gurumodem/design/GuruModem.kicad_pcb

## KiCad design GuruModem.kicad_pcb (2019-03-13)

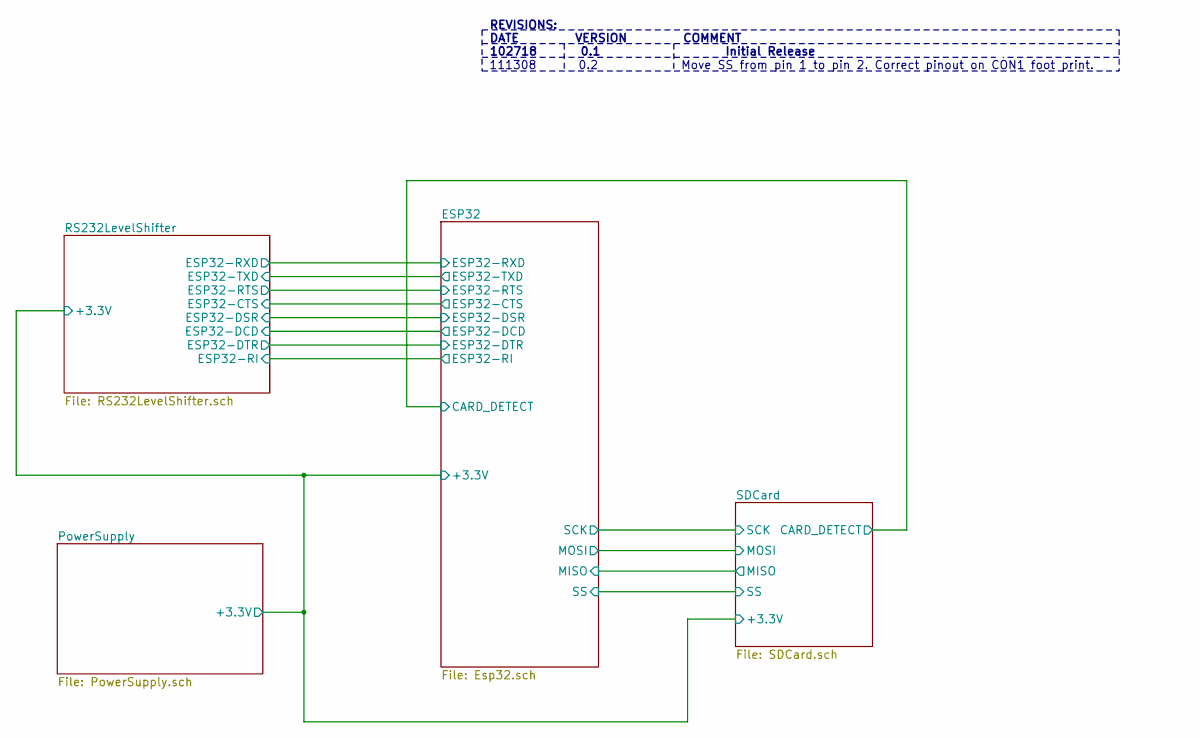
[picture p1: schematic GuruModem.sch, Guru Modem]

Notes on the sheet:
REVISIONS: DATE VERSION COMMENT 102718 0.1 Initial Release
111308
0.2
Move SS from pin 1 to pin 2. Correct pinout on CON1 foot print.

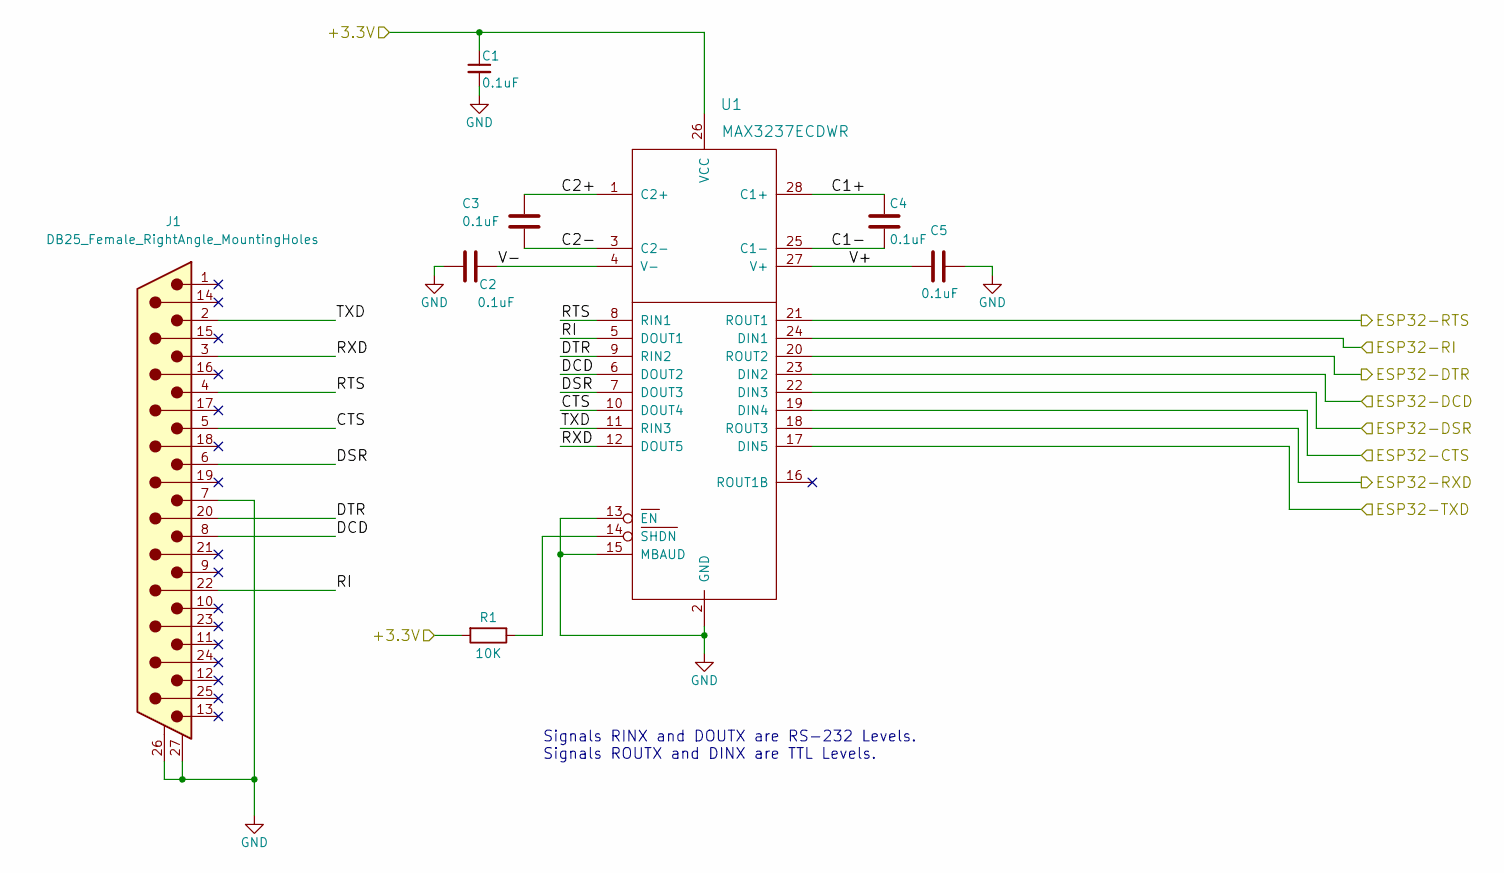
[picture p2: schematic RS232LevelShifter.sch, Guru Modem]

Parts:
C1, C2, C3, C4, C5: 0.1uF; C_0805
J1: DB25_Female_RightAngle_MountingHoles; DSUB-25_Female_RightAngle_MountingHoles
R1: 10K; R_0805
U1: MAX3237ECDWR; SOIC-28DW

Connections:
+3V3: C1.1, R1.2, U1.26 (VCC); also elsewhere on the board
/ESP32/ESP32-CTS: U1.19 (DIN4); also elsewhere on the board
/ESP32/ESP32-DCD: U1.23 (DIN2); also elsewhere on the board
/ESP32/ESP32-DSR: U1.22 (DIN3); also elsewhere on the board
/ESP32/ESP32-DTR: U1.20 (ROUT2); also elsewhere on the board
/ESP32/ESP32-RI: U1.24 (DIN1); also elsewhere on the board
/ESP32/ESP32-RTS: U1.21 (ROUT1); also elsewhere on the board
/ESP32/ESP32-RXD: U1.18 (ROUT3); also elsewhere on the board
/ESP32/ESP32-TXD: U1.17 (DIN5); also elsewhere on the board
/RS232LevelShifter/C1+: C4.1, U1.28 (C1+)
/RS232LevelShifter/C1-: C4.2, U1.25 (C1-)
/RS232LevelShifter/C2+: C3.1, U1.1 (C2+)
/RS232LevelShifter/C2-: C3.2, U1.3 (C2-)
/RS232LevelShifter/CTS: J1.5, U1.10 (DOUT4)
/RS232LevelShifter/DCD: J1.8, U1.6 (DOUT2)
/RS232LevelShifter/DSR: J1.6, U1.7 (DOUT3)
/RS232LevelShifter/DTR: J1.20, U1.9 (RIN2)
/RS232LevelShifter/RI: J1.22, U1.5 (DOUT1)
/RS232LevelShifter/RTS: J1.4, U1.8 (RIN1)
/RS232LevelShifter/RXD: J1.3, U1.12 (DOUT5)
/RS232LevelShifter/TXD: J1.2, U1.11 (RIN3)
/RS232LevelShifter/V+: C5.2, U1.27 (V+)
/RS232LevelShifter/V-: C2.2, U1.4 (V-)
GND: C1.2, C2.1, C5.1, J1.7, J1.26 (GND), J1.27 (GND), U1.2 (GND), U1.13 (EN), U1.15 (MBAUD); also elsewhere on the board
unnamed: R1.1, U1.14 (SHDN)

Notes on the sheet:
Signals RINX and DOUTX are RS-232 Levels. Signals ROUTX and DINX are TTL Levels.

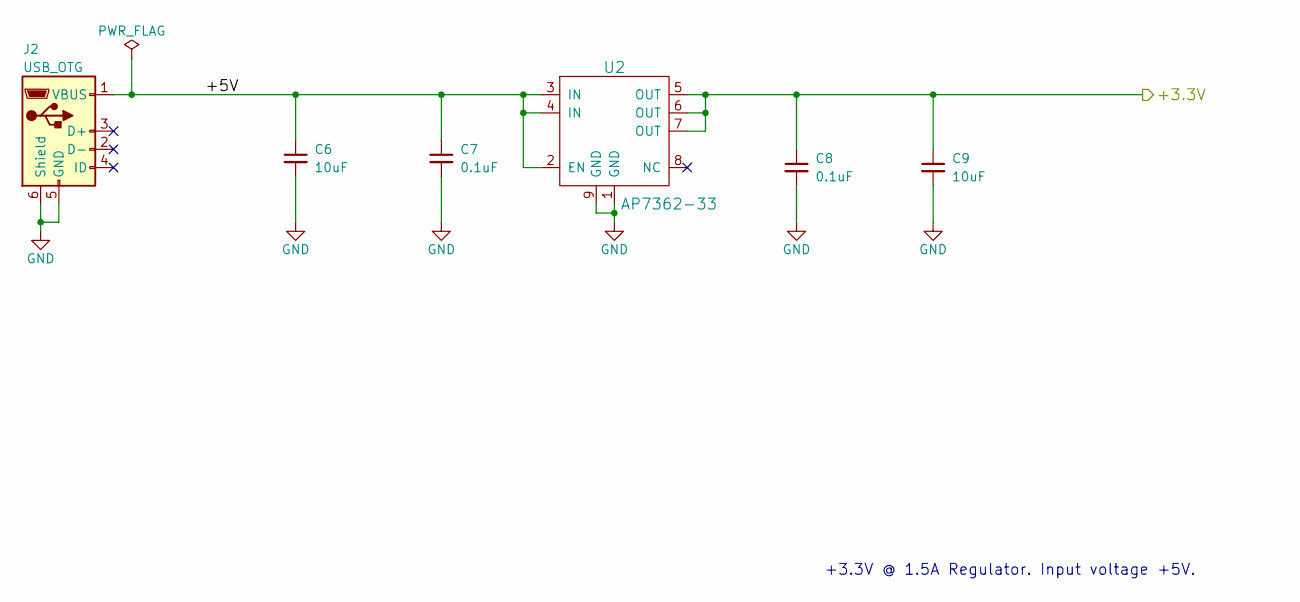
[picture p3: schematic PowerSupply.sch, Guru Modem]

Parts:
C6, C9: 10uF; C_0805
C7, C8: 0.1uF; C_0805
J2: USB_OTG; CUI_Micro_USB_SMT_UJ2-MIBH2-4-SMT
U2: AP7362-33; SO-8EP

Connections:
+3V3: C8.1, C9.1, U2.5 (OUT), U2.6 (OUT), U2.7 (OUT); also elsewhere on the board
/PowerSupply/+5V: C6.1, C7.1, J2.1 (VBUS), U2.2 (EN), U2.3 (IN), U2.4 (IN)
GND: C6.2, C7.2, C8.2, C9.2, J2.5 (GND), J2.6 (Shield), U2.1 (GND), U2.9 (GND); also elsewhere on the board

Notes on the sheet:
+3.3V @ 1.5A Regulator. Input voltage +5V.

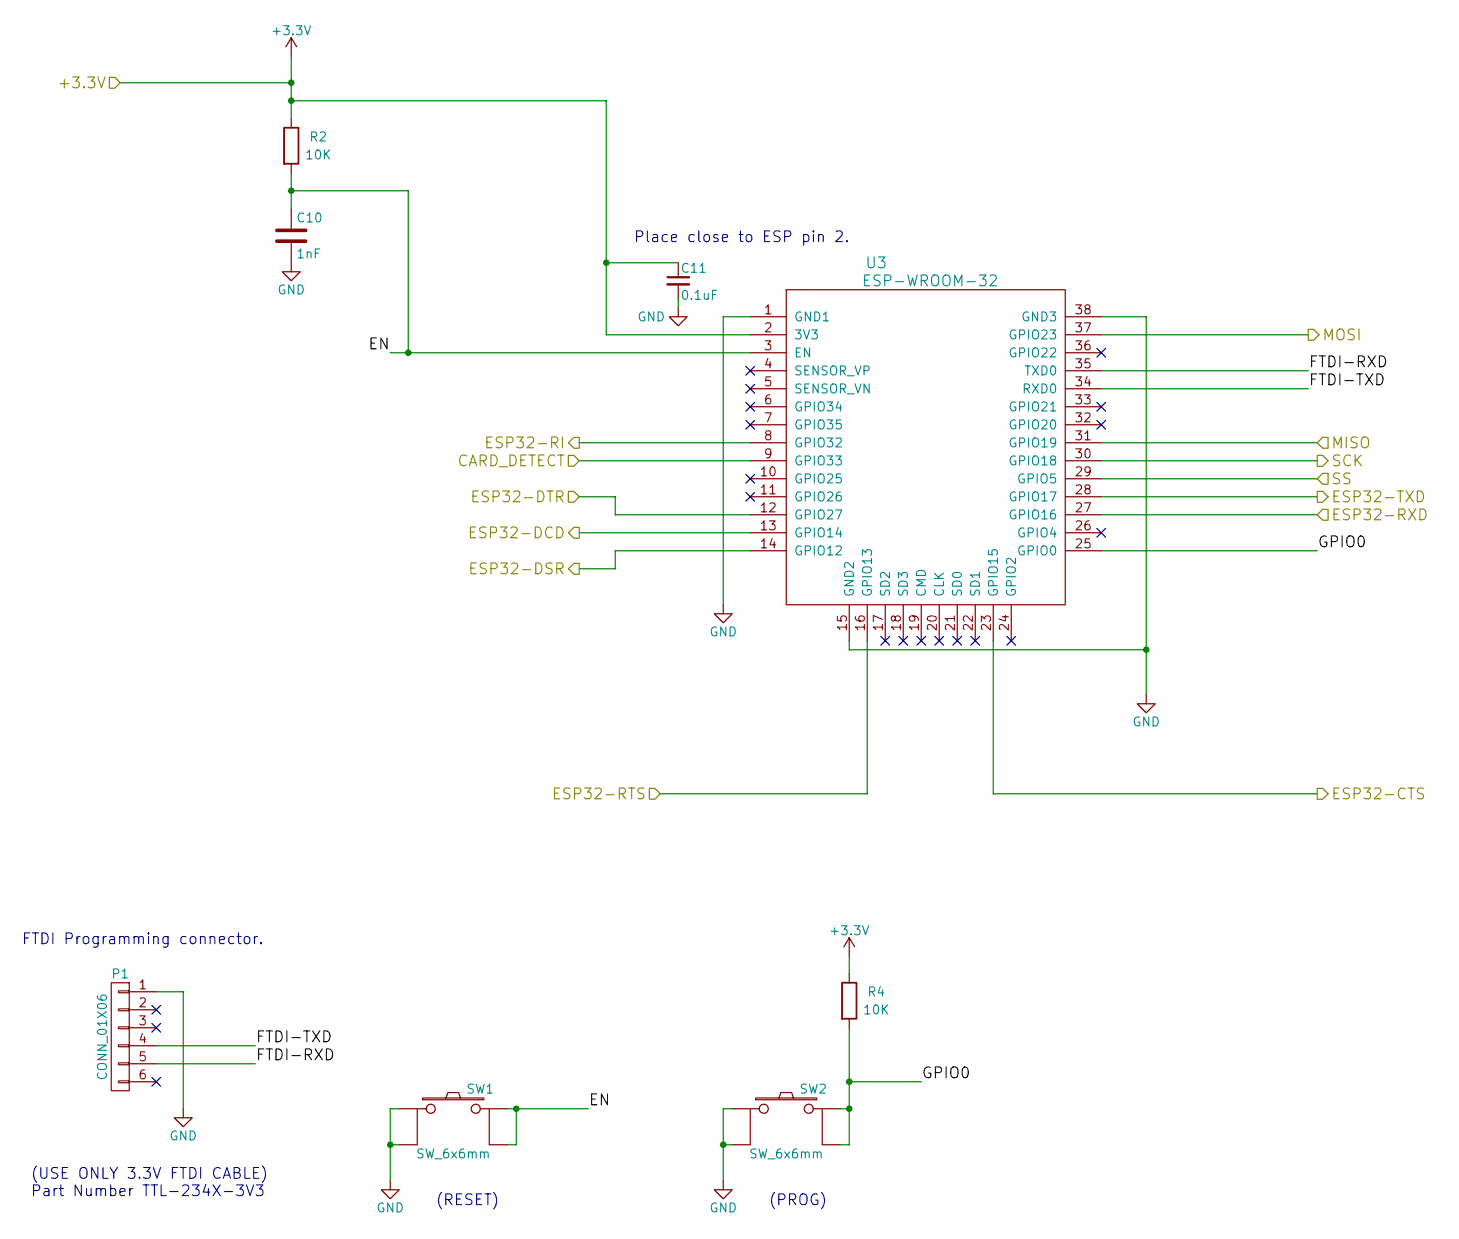
[picture p4: schematic Esp32.sch, Guru Modem]

Parts:
C10: 1nF; C_0805
C11: 0.1uF; C_0805
P1: CONN_01X06; HDR_6-PIN_STAGGERD
R2, R4: 10K; R_0805
SW1, SW2: SW_6x6mm; Micro-PUSHBUTTON
U3: ESP-WROOM-32

Connections:
+3V3: C11.1, R2.1, R4.1, U3.2 (3V3); also elsewhere on the board
/ESP32/CARD_DETECT: U3.9 (GPIO33); also elsewhere on the board
/ESP32/EN: C10.1, R2.2, SW1.3, SW1.4, U3.3 (EN)
/ESP32/ESP32-CTS: U3.23 (GPIO15); also elsewhere on the board
/ESP32/ESP32-DCD: U3.13 (GPIO14); also elsewhere on the board
/ESP32/ESP32-DSR: U3.14 (GPIO12); also elsewhere on the board
/ESP32/ESP32-DTR: U3.12 (GPIO27); also elsewhere on the board
/ESP32/ESP32-RI: U3.8 (GPIO32); also elsewhere on the board
/ESP32/ESP32-RTS: U3.16 (GPIO13); also elsewhere on the board
/ESP32/ESP32-RXD: U3.27 (GPIO16); also elsewhere on the board
/ESP32/ESP32-TXD: U3.28 (GPIO17); also elsewhere on the board
/ESP32/FTDI-RXD: P1.5, U3.35 (TXD0)
/ESP32/FTDI-TXD: P1.4, U3.34 (RXD0)
/ESP32/GPIO0: R4.2, SW2.3, SW2.4, U3.25 (GPIO0)
/ESP32/MISO: U3.31 (GPIO19); also elsewhere on the board
/ESP32/MOSI: U3.37 (GPIO23); also elsewhere on the board
/ESP32/SCK: U3.30 (GPIO18); also elsewhere on the board
/ESP32/SS: U3.29 (GPIO5); also elsewhere on the board
GND: C10.2, C11.2, P1.1, SW1.1, SW1.2, SW2.1, SW2.2, U3.1 (GND1), U3.15 (GND2), U3.38 (GND3), U3.39 (GND); also elsewhere on the board

Notes on the sheet:
Place close to ESP pin 2.
FTDI Programming connector.
(RESET)
(USE ONLY 3.3V FTDI CABLE) Part Number TTL-234X-3V3
(PROG)

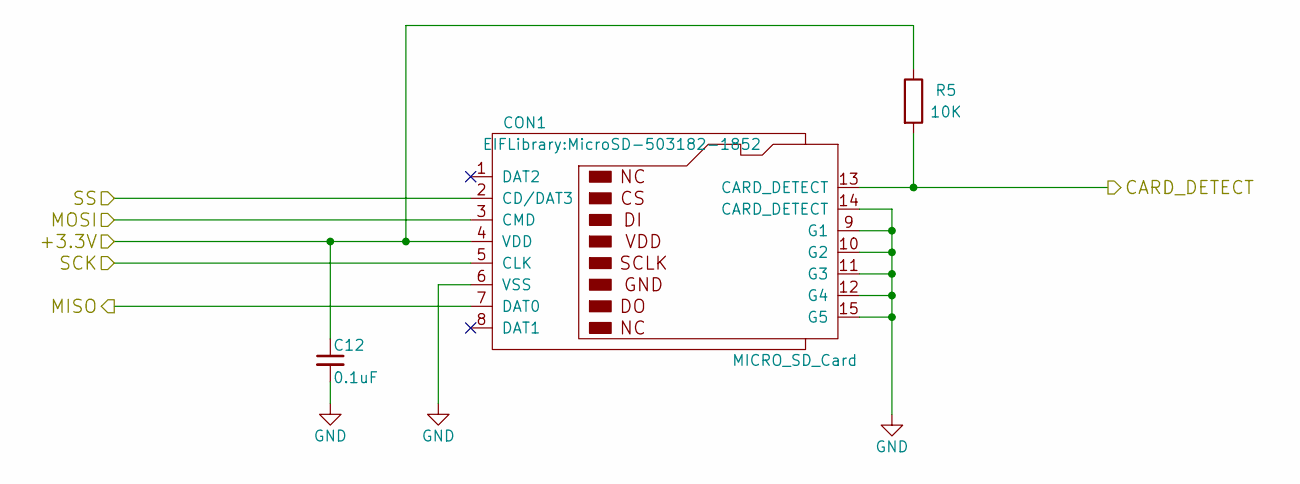
[picture p5: schematic SDCard.sch, Guru Modem]

Parts:
C12: 0.1uF; C_0805
CON1: MICRO_SD_Card; MicroSD-503182-1852
R5: 10K; R_0805

Connections:
+3V3: C12.1, CON1.4 (VDD), R5.1; also elsewhere on the board
/ESP32/CARD_DETECT: CON1.13 (CARD_DETECT), R5.2; also elsewhere on the board
/ESP32/MISO: CON1.7 (DAT0); also elsewhere on the board
/ESP32/MOSI: CON1.3 (CMD); also elsewhere on the board
/ESP32/SCK: CON1.5 (CLK); also elsewhere on the board
/ESP32/SS: CON1.2 (CD/DAT3); also elsewhere on the board
GND: C12.2, CON1.6 (VSS), CON1.9 (G1), CON1.10 (G2), CON1.11 (G3), CON1.12 (G4), CON1.14 (CARD_DETECT), CON1.15 (G5); also elsewhere on the board

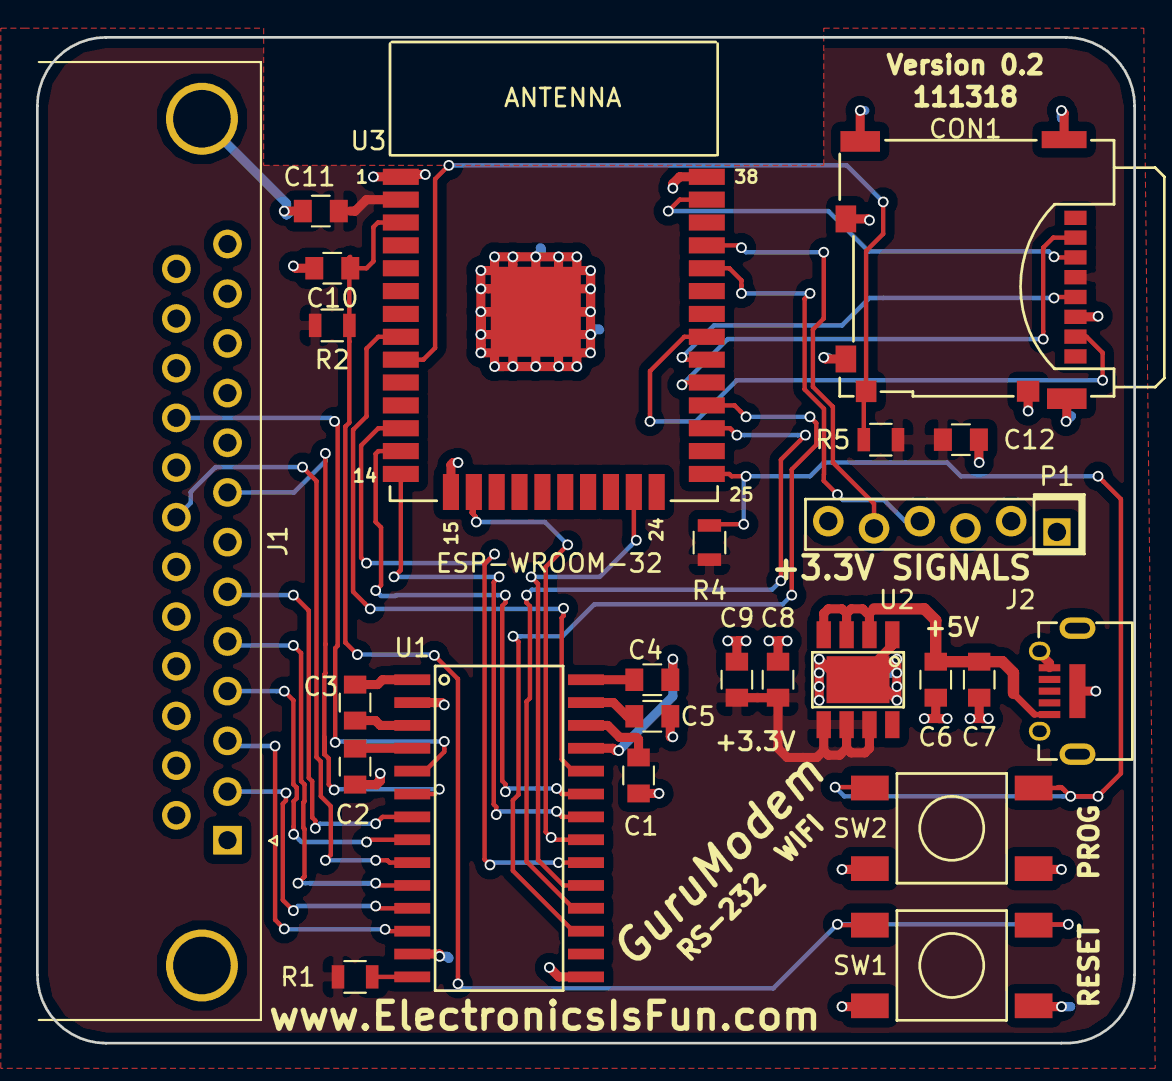
[picture p6: board GuruModem.kicad_pcb from above]

Board: 2 copper layers, 61.0 x 55.9 mm, 25 parts (0 on the bottom side), 35 nets.
